schuylersg/Brunei_Brain/Brunei_Brain.brd

## EAGLE design Brunei_Brain.brd (2014-01-03)

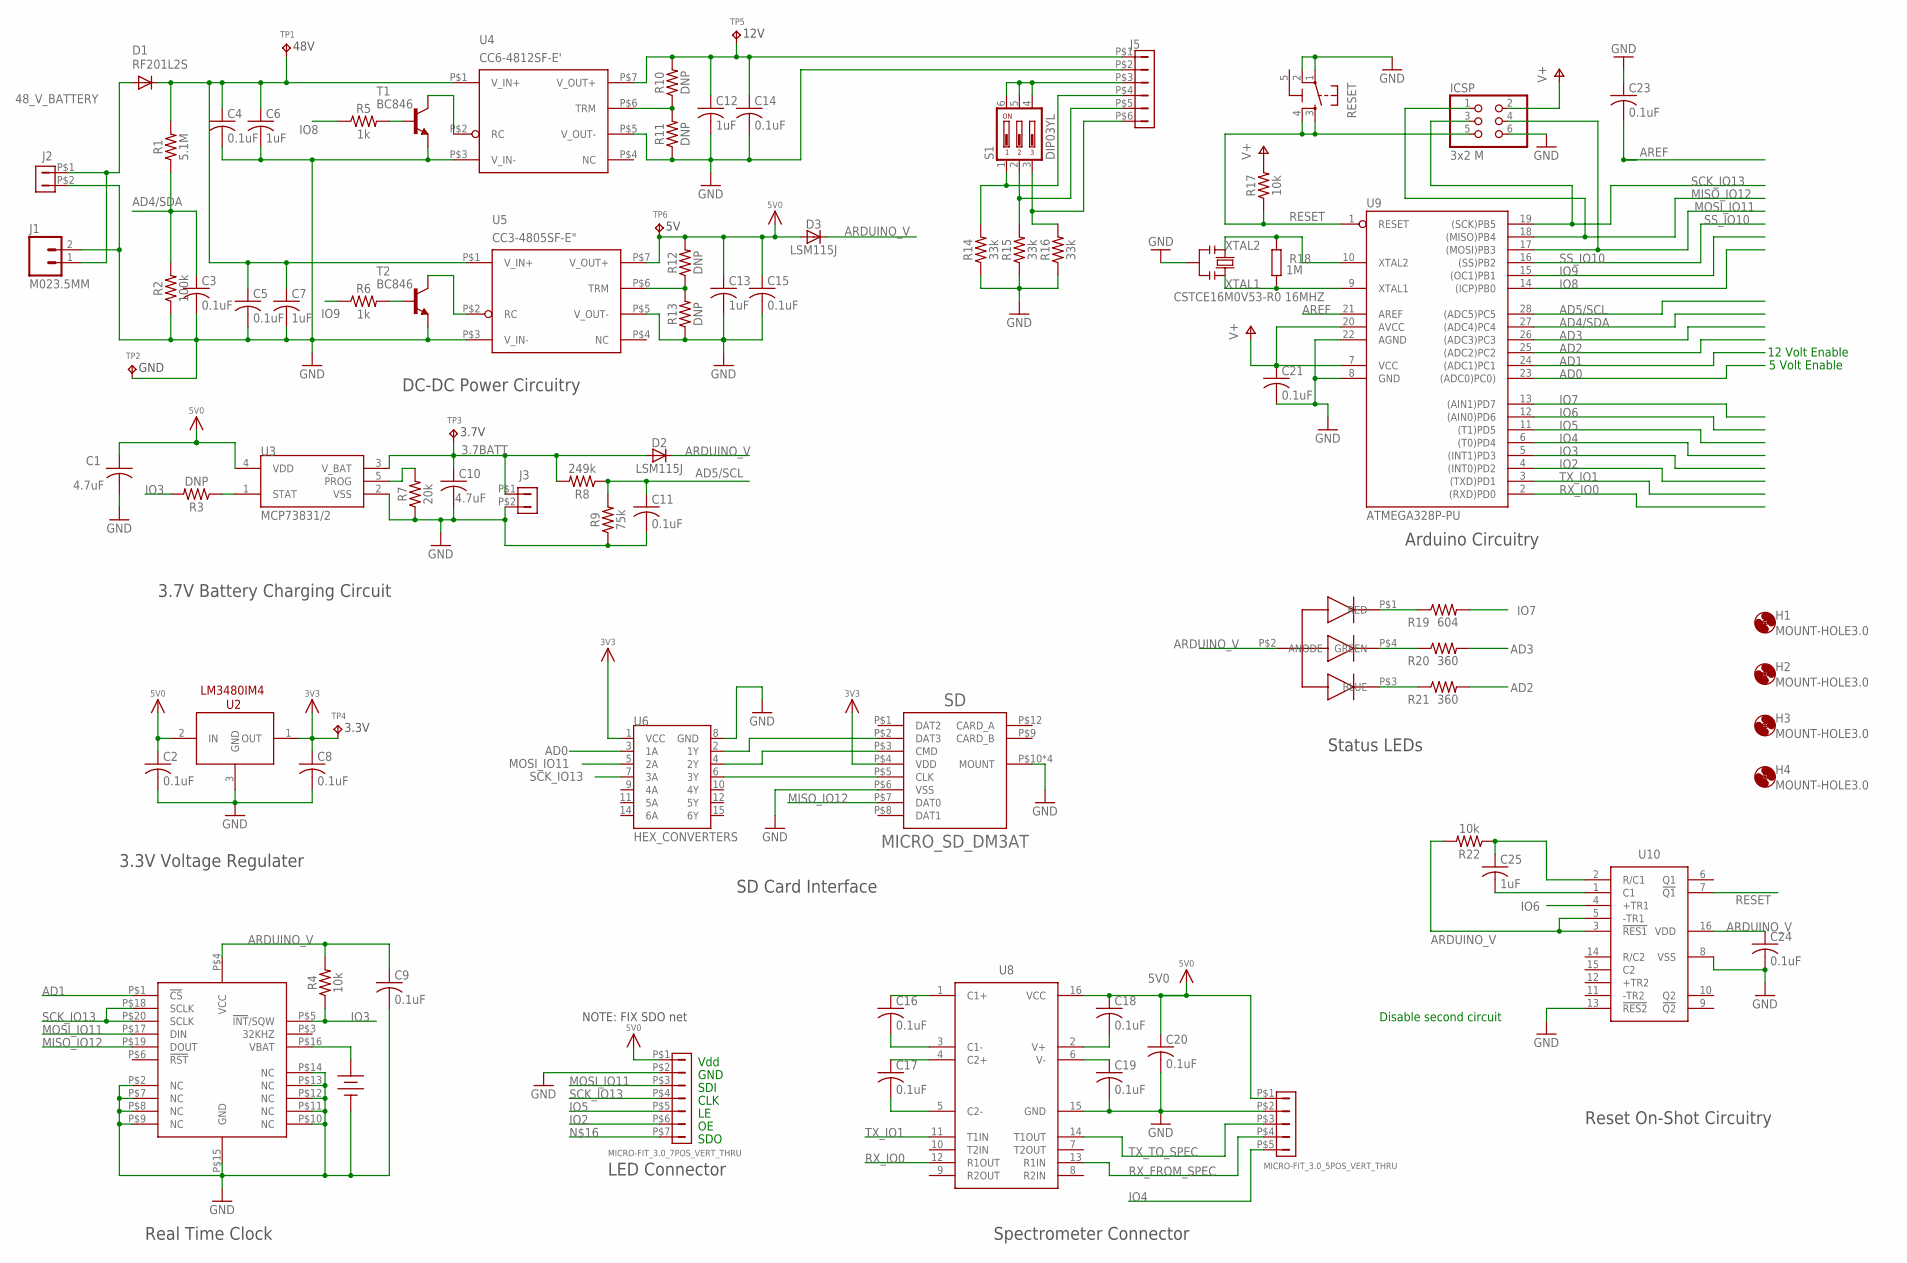
[picture p1: schematic Brunei_Brain.sch]

Parts:
B1: BATTERY_12MM; KEYSTONE_12MM_BATT_SM
C1, C10: 4.7uF; C0603; PARTNUMBER 445-5178-1-ND
C2, C3, C4, C5, C8, C9, C11, C14, C15, C16, C17, C18, C19, C20, C21, C23, C24: 0.1uF; C0603; PARTNUMBER 311-1523-1-ND
C6, C7, C12, C13, C25: 1uF; C1206; PARTNUMBER 1276-2747-1-ND
D1: RF201L2S; SOD-106
D2, D3: LSM115J; DO-214BA
D4: RGB_LED_COMMON_ANODE_1; PLCC-4
H1, H2, H3, H4: MOUNT-HOLE3.0; 3,0
ICSP: 3x2 M; 2X03
J1: M023.5MM; SCREWTERMINAL-3.5MM-2; MANPARTNUMBER 1984617
J2, J3: MICRO-FIT_3.0_2POS_VERT_THRU; MICRO-FIT_3.0_2POS_VERT_THROUGH
J4: MICRO-FIT_3.0_7POS_VERT_THRU; MICRO-FIT_3.0_7POS_VERT_THROUGH
J5: MICRO-FIT_3.0_6POS_VERT_THRU; MICRO-FIT_3.0_6POS_VERT_THROUGH
J6: MICRO-FIT_3.0_5POS_VERT_THRU; MICRO-FIT_3.0_5POS_VERT_THROUGH
R1: 5.1M; 0603-RES; PARTNUMBER 541-5.10MHCT-ND
R2: 100k; 0603-RES; PARTNUMBER 1276-3486-1-ND
R3, R10, R11, R12, R13: DNP; 0603-RES
R4, R17, R22: 10k; 0603-RES; PARTNUMBER 311-10.0KHRCT-ND
R5, R6: 1k; 0603-RES; PARTNUMBER 1276-5062-1-ND
R7: 20k; 0603-RES; PARTNUMBER 1276-4768-1-ND
R8: 249k; 0603-RES; PARTNUMBER 311-249KHRCT-ND
R9: 75k; 0603-RES; PARTNUMBER 311-75.0KHRCT-ND
R14, R15, R16: 33k; 0603-RES; PARTNUMBER 311-33KGRCT-ND
R18: 1M; R0603-ROUND; PARTNUMBER P1.00MHCT-ND
R19: 604; 0603-RES; PARTNUMBER 1276-3506-1-ND
R20, R21: 360; 0603-RES; PARTNUMBER 1276-5051-1-ND
RESET: TS42031-160R-TR-7260; TS42; PARTNUMBER 450-1759-1-ND
S1: DIP03YL
SD: MICRO_SD_DM3AT; MICROSD_DM3AT
T1, T2: BC846; SOT23; PARTNUMBER MMBT2484LT1GOSCT-ND
TP1, TP2, TP3, TP4, TP5, TP6: TPPAD1-13; P1-13
U1: DS3234; SOIC-20_MAXIM
U2: LM3480IM4; SOT23-3
U3: MCP73831/2; SOT23-5
U4: CC6-4812SF-E'; CC6-XXXXXF-E
U5: CC3-4805SF-E"; CC3-XXXXXF-E
U6: HEX_CONVERTERS; SO-16_SSG; PARTNUMBER 568-1453-5-ND
U8: ST232; SO-16_SSG
U9: ATMEGA328P-PU; DIL28-3; PARTNUMBER ATMEGA328P-PN-ND
U10: MULTIVIBRATOR_DUAL; SO-16_SSG
Y1: CSTCE16M0V53-R0 16MHZ; RESONATOR; PARTNUMBER 490-1198-1-ND

Connections:
3.7BATT: C10.1, D2.P$1 (A), J3.P$1, R8.2, TP3.TP, U3.3 (V_BAT)
3V3: C8.1, SD.P$4 (VDD), TP4.TP, U2.1 (OUT), U6.1 (VCC)
5-GND: RESET.5 (5-GND)
5V0: C1.1, C2.1, C13.1, C15.1, C18.1, C20.1, D3.P$1 (A), J4.P$1, J6.P$1, R12.2, TP6.TP, U2.2 (IN), U3.4 (VDD), U5.P$7 (V_OUT+), U8.16 (VCC)
12V: C12.1, C14.1, J5.P$1, R10.2, TP5.TP, U4.P$7 (V_OUT+)
48V: C4.1, C5.1, C6.1, C7.1, D1.P$2 (C), R1.2, TP1.TP, U4.P$1 (V_IN+), U5.P$1 (V_IN+)
48_V_BATTERY: D1.P$1 (A), J1.1, J2.P$1
AD0: U6.3 (1A), U9.23 ((ADC0)PC0))
AD1: U1.P$1 (!CS), U9.24 ((ADC1)PC1)
AD2: R21.2, U9.25 ((ADC2)PC2)
AD3: R20.2, U9.26 ((ADC3)PC3)
AD4/SDA: C3.1, R1.1, R2.2, U9.27 ((ADC4)PC4)
AD5/SCL: C11.1, R8.1, R9.2, U9.28 ((ADC5)PC5)
ARDUINO_V: C9.1, C21.1, C24.1, D2.P$2 (C), D3.P$2 (C), D4.P$2 (ANODE), ICSP.2, R4.2, R17.2, R22.2, U1.P$4 (VCC), U9.7 (VCC), U9.20 (AVCC), U10.3 (!RES1), U10.5 (-TR1), U10.16 (VDD)
AREF: C23.2, U9.21 (AREF)
DEUTERIUM_ENABLE: J5.P$4, R14.2, S1.1
GND: B1.P$3 (V-), C1.2, C2.2, C3.2, C4.2, C5.2, C6.2, C7.2, C8.2, C9.2, C10.2, C11.2, C12.2, C13.2, C14.2, C15.2, C19.2, C20.2, C21.2, C23.1, C24.2, ICSP.6, J1.2, J2.P$2, J3.P$2, J4.P$2, J5.P$2, J6.P$2, R2.1, R7.1, R9.1, R11.1, R13.1, R14.1, R15.1, R16.1, RESET.1, RESET.2, SD.P$6 (VSS), SD.P$10 (MOUNT), SD.P$11 (MOUNT), SD.P$13 (MOUNT), SD.P$14 (MOUNT), T1.2 (E), T2.2 (E), TP2.TP, U1.P$2 (NC), U1.P$7 (NC), U1.P$8 (NC), U1.P$9 (NC), U1.P$10 (NC), U1.P$11 (NC), U1.P$12 (NC), U1.P$13 (NC), U1.P$14 (NC), U1.P$15 (GND), U2.3 (GND), U3.2 (VSS), U4.P$3 (V_IN-), U4.P$5 (V_OUT-), U5.P$3 (V_IN-), U5.P$5 (V_OUT-), U6.8 (GND), U8.15 (GND), U9.8 (GND), U9.22 (AGND), U10.8 (VSS), U10.13 (!RES2), Y1.2
IO2: J4.P$6, U9.4 ((INT0)PD2)
IO3: R3.2, R4.1, U1.P$5 (!INT!/SQW), U9.5 ((INT1)PD3)
IO4: J6.P$5, U9.6 ((T0)PD4)
IO5: J4.P$5, U9.11 ((T1)PD5)
IO6: U9.12 ((AIN0)PD6), U10.4 (+TR1)
IO7: R19.2, U9.13 ((AIN1)PD7)
IO8: R5.1, U9.14 ((ICP)PB0)
IO9: R6.1, U9.15 ((OC1)PB1)
LAMP_5V: J5.P$3, S1.4, S1.5, S1.6
MISO_IO12: ICSP.1, SD.P$7 (DAT0), U1.P$19 (DOUT), U9.18 ((MISO)PB4)
MOSI_IO11: ICSP.4, J4.P$3, U1.P$17 (DIN), U6.5 (2A), U9.17 ((MOSI)PB3)
unnamed: T2.3 (C), U5.P$2 (RC)
unnamed: T1.3 (C), U4.P$2 (RC)
unnamed: R5.2, T1.1 (B)
unnamed: R6.2, T2.1 (B)
unnamed: R12.1, R13.2, U5.P$6 (TRM)
unnamed: B1.P$1 (V+), B1.P$2 (V+), U1.P$16 (VBAT)
unnamed: R7.2, U3.5 (PROG)
unnamed: SD.P$3 (CMD), U6.4 (2Y)
unnamed: SD.P$5 (CLK), U6.6 (3Y)
unnamed: R3.1, U3.1 (STAT)
unnamed: C25.2, U10.1 (C1)
unnamed: C25.1, R22.1, U10.2 (R/C1)
unnamed: D4.P$1 (RED), R19.1
unnamed: D4.P$4 (GREEN), R20.1
unnamed: D4.P$3 (BLUE), R21.1
unnamed: C16.1, U8.1 (C1+)
unnamed: R10.1, R11.2, U4.P$6 (TRM)
unnamed: C16.2, U8.3 (C1-)
unnamed: C17.1, U8.4 (C2+)
unnamed: C17.2, U8.5 (C2-)
unnamed: C19.1, U8.6 (V-)
unnamed: C18.2, U8.2 (V+)
unnamed: SD.P$2 (DAT3), U6.2 (1Y)
RESET: ICSP.5, R17.1, RESET.3, RESET.4, U9.1 (RESET), U10.7 (!Q1)
RX_FROM_SPEC: J6.P$4, U8.13 (R1IN)
RX_IO0: U8.12 (R1OUT), U9.2 ((RXD)PD0)
SCK_IO13: ICSP.3, J4.P$4, U1.P$18 (SCLK), U1.P$20 (SCLK), U6.7 (3A), U9.19 ((SCK)PB5)
SHUTTER_ENABLE: J5.P$6, R16.2, S1.3
SS_IO10: U9.16 ((SS)PB2)
TUNGSTEN_ENABLE: J5.P$5, R15.2, S1.2
TX_IO1: U8.11 (T1IN), U9.3 ((TXD)PD1)
TX_TO_SPEC: J6.P$3, U8.14 (T1OUT)
XTAL1: R18.1, U9.9 (XTAL1), Y1.3
XTAL2: R18.2, U9.10 (XTAL2), Y1.1

Notes on the sheet:
DC-DC Power Circuitry
Arduino Circuitry
3.7V Battery Charging Circuit
3.3V Voltage Regulater
SD Card Interface
Real Time Clock
LED Connector
Spectrometer Connector
Reset On-Shot Circuitry
Status LEDs
Vdd
GND
SDI
CLK
SDO
Disable second circuit
5 Volt Enable
12 Volt Enable
NOTE: FIX SDO net

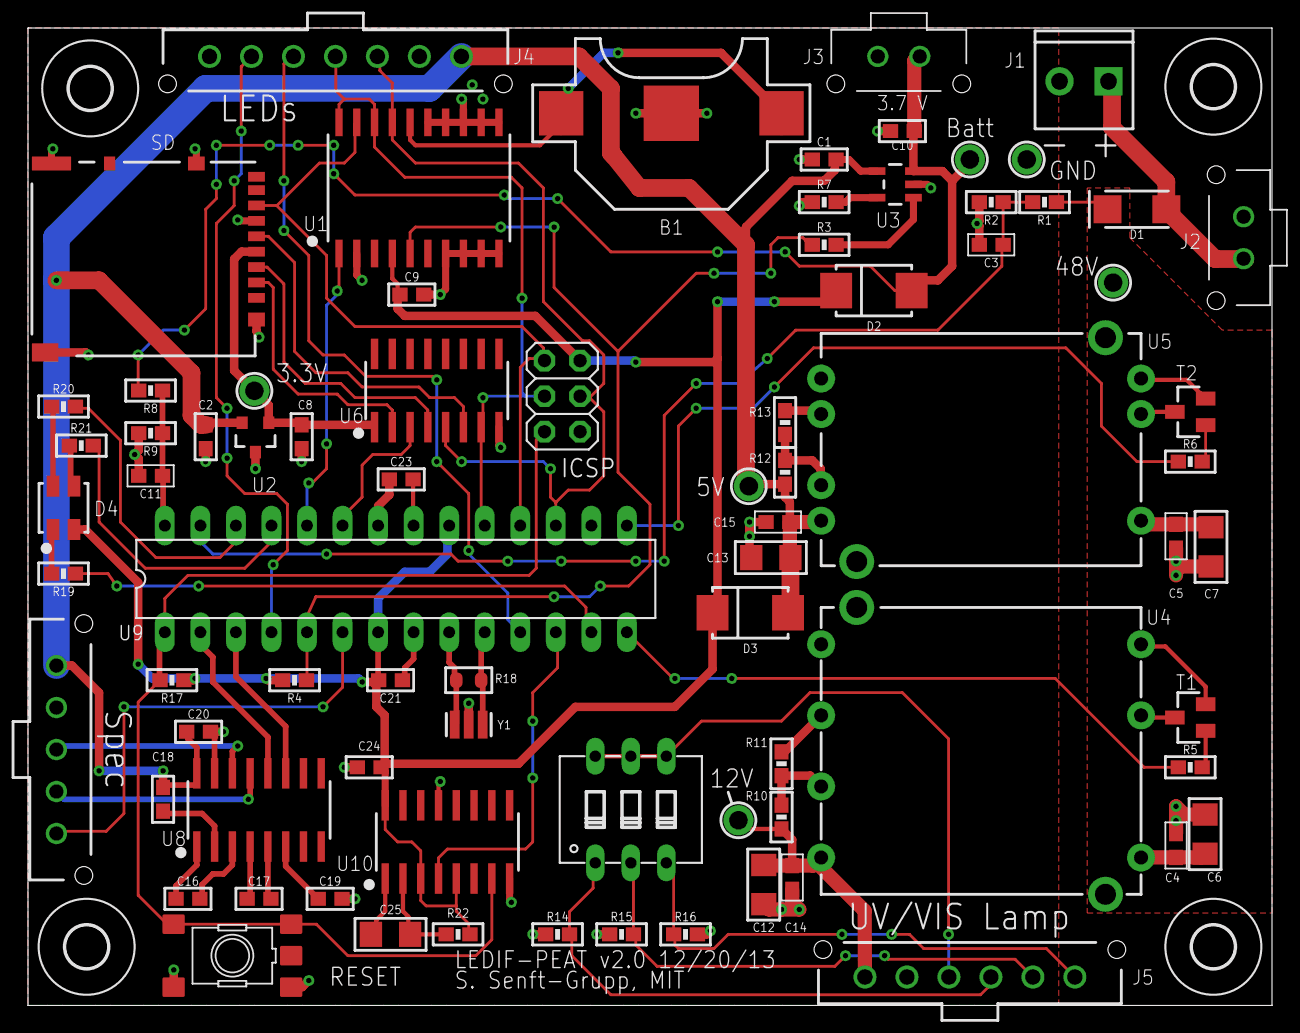
[picture p2: board Brunei_Brain.brd from above]

Board: 2 copper layers, 88.9 x 69.8 mm, 83 parts (0 on the bottom side), 60 nets.
