schuylersg/Brunei_Brain/(commit log)

2013-11-21 Version 1
    [Brunei_Brain.brd, Brunei_Brain.sch]
2013-11-27 Started v2 update process.
    [Brunei_Brain.brd, Brunei_Brain.sch]
2013-12-17 some continuing updates
    [Brunei_Brain.brd, Brunei_Brain.sch]
2013-12-21 Version 2.0 Complete
    [Brunei_Brain.brd, Brunei_Brain.sch]
2014-01-03 Updated part attributes for ordering
    [Brunei_Brain.brd, Brunei_Brain.sch]
